cachatj/cistern-water-level-monitor/prompts-plans/display-mockups.md

This mockup looks fantastic. It’s incredibly clean, data-dense without being cluttered, and perfectly optimized for a high-contrast black-and-white e-ink screen. It's an ideal frontend for the wireless water tank level monitor.

To get this rendering beautifully on your Elecrow 5.79" display via PlatformIO, we need to adjust the approach slightly from your previous web-based iterations.

Here is the breakdown of how to translate this design into reality.

### 1. The HTML vs. C++ Reality Check

While HTML/CSS is the absolute best language for a *web dashboard* (e.g., if your ESP32 is hosting a webpage that you view on your phone), it cannot be used to drive the physical e-ink display directly.

Because the Elecrow panel is driven by an SPI interface, the ESP32 needs to send raw pixel data directly to the screen's controller. Therefore, the display code must be written in **C/C++**.

### 2. The Graphics Library Question

Yes, you will absolutely need a graphics library within PlatformIO. You don't want to be calculating individual pixel coordinates from scratch.

For this specific hardware stack, you should target the following:

* **The Display Driver:** **`GxEPD2`** is the gold standard library for e-paper displays in the Arduino/PlatformIO ecosystem. It supports partial refresh (crucial for updating just the "Current: 1,332 gal" text without flashing the whole screen) and handles the complex SPI timing.
* **The Graphics Core:** `Adafruit_GFX`. The `GxEPD2` library inherits from Adafruit's graphics core, which gives you access to simple drawing primitives: `drawRect`, `fillCircle`, `drawLine`, and custom fonts.
* **Fonts:** You will need a custom font library to get those clean, modern typefaces. The `U8g2_for_Adafruit_GFX` library is perfect for this, allowing you to load crisp, anti-aliased fonts onto the ESP32.

*Note: You could look into a heavy UI framework like LVGL, but for a static, non-touch dashboard like this, drawing primitives via Adafruit_GFX is often much lighter on the ESP32's memory and easier to code.*

### 3. How to Prompt the LLMs

When you take this mockup to Gemini Advanced, Claude 3.5 Sonnet, or an IDE assistant, handing them the image alone and saying "code this" will often result in a jumbled mess of misaligned coordinates. AI struggles with exact spatial reasoning from images to C++ canvas coordinates.

To get the best C++ code, you should act as the "layout engine" in your prompt. Give the AI the image, but pair it with a structured prompt like this:

> **System & Hardware:**
> I am building an IoT dashboard using PlatformIO. The hardware is an ESP32 driving an Elecrow 5.79 Inch E-Paper display via SPI. Resolution is 272 (height) x 792 (width), Black/White only.
> **Libraries:**
> Please use `GxEPD2` for the display driver and `Adafruit_GFX` drawing primitives (`drawRect`, `drawLine`, `setCursor`, etc.).
> **Task:**
> Write the C++ layout code for the attached mockup. Do not worry about the sensor logic yet, just create a `drawDashboard()` function with hardcoded dummy variables (e.g., `int currentGallons = 1332;`) so I can test the layout.
> **Layout Constraints (Please follow these coordinate zones):**
> 1. **Left Panel (Width: ~250px):** >    - Draw a large rounded rectangle for the cistern outline.
> * Fill a dynamic rectangle inside it based on a `percentage` variable (currently 73%).
> * Print "73 PERCENT" centered inside the tank.
> 
> 
> 2. **Center Column (Width: ~150px):**
> * Status: Triangle pointing up, text "RISING".
> * Capacity: 1,825 gal
> * Current: 1,332 gal
> * Daily Use: ~45 gal/day
> * Days Remaining: ~29 days (use a larger, bold font for this).
> 
> 
> 3. **Right Panel (Width: ~392px):**
> * Top row: 7 icons representing weather (Mon-Sun). Use simple geometric shapes if actual icons aren't available in the font.
> * Main chart: Draw a line graph showing a 7-day trend. Include a faint grid background (`drawLine` with a dithered pattern or thin lines).
> * Bar chart: Draw two filled rectangles at the bottom of the graph to represent "Rain Measured".
> 
> 
> 4. **Footer:**
> * Left: "Sensor: 42.1cm | Updated 10:42 AM"
> * Right: "Battery Level: 95% | ESP32 CONNECTED"
> 
> 
> 
> 

By breaking the prompt down into "zones" and explicitly naming the libraries (`GxEPD2` and `Adafruit_GFX`), the AI will output highly structured, easy-to-tweak C++ code instead of guessing how to render a web page on an SPI screen.
