cachatj/cistern-water-level-monitor/prompts-plans/System Architecture.png

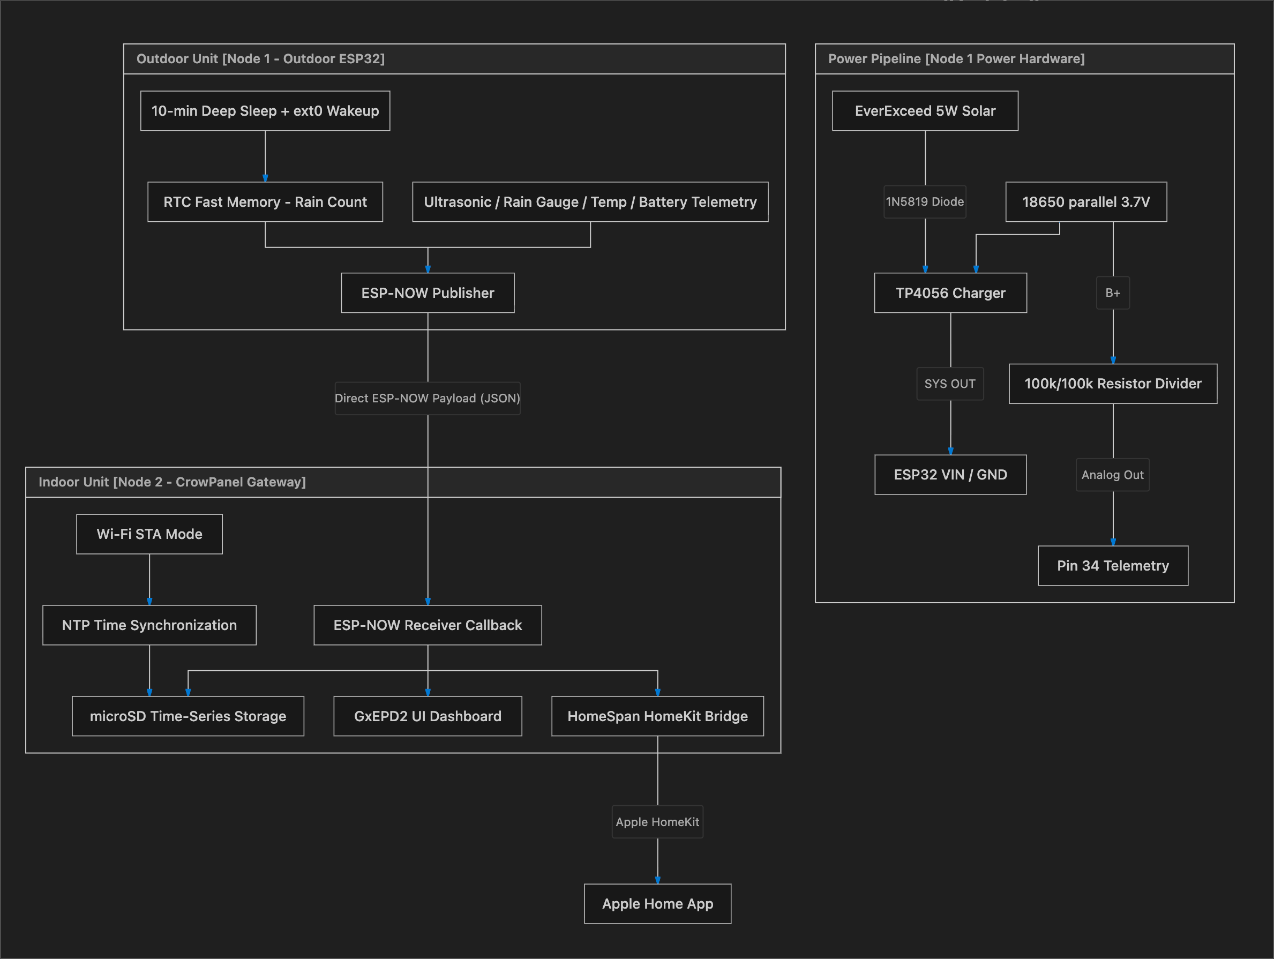
prompts-plans/System Architecture.png
