cachatj/cistern-water-level-monitor/prompts-plans/cister-water-monitor-build-notes.md

CrowPanel MAC Address: 44:1B:F6:95:55:24

smaller speakers look more stable, larger one looks like it could tip easily. also white will get dirty fast

Timestamp, Distance_cm, Gallons, Percentage, Battery_pct, Temp_c, Rain_tips

measured_on, water_surface_dist_cm, estimated_gallons, cistern_percentage, battery_percentage, temp_c, rain_tips
