cachatj/cistern-water-level-monitor/Cistern Node Wiring.html

Cistern Water Level Monitor · Outdoor node · Rev 2

# Outdoor node wiring

Drawn from the updated README (Oct 7, 2026). Pins use the labels printed on the board (D18, VIN). The small text under each one gives the GPIO number used in code and where the pin sits on the board. The sensor wiring is the same in both modes. Only the power source and the top of the battery divider change.

Bench test (USB) Field (solar + battery) Bench test (USB) breadboard

Bench test on your 400-point breadboard. In each numbered row, holes a–e are connected and holes f–j are connected; the center groove separates them. The left strips carry 3V3 (+, red line) and GND (−, blue line). The right strips carry 5V and GND. The ESP32 stays on its terminal adapter beside the board. Wire colors are suggestions, and wires that cross are not connected. The ringed hole in row 26 is the battery-sense test point.

Wire or part | From | To | Purpose
orange wire | ESP32 3V3 terminal | Left + strip, row 29 | Makes the left + strip the 3.3 V rail
black wire | ESP32 GND terminal (right block) | Left − strip, row 28 | Ground
red wire | ESP32 VIN terminal | Right + strip, row 25 | Makes the right + strip the 5 V rail (USB 5 V)
black wire | Left − strip, row 1 | Right − strip, row 1 | Joins the two ground strips
yellow wire | JSN-SR04T Echo | 3j | Echo before the divider (5 V)
R1 · 1 kΩ | 3g | 7g | Divider, top
R2a · 2.2 kΩ | 7h | 11h | Divider, bottom (with R2b)
R2b · 22 kΩ | 7i | 11i | In parallel with R2a = 2.0 kΩ
black wire | 11j | Right − strip, row 11 | Divider to ground
blue wire | 7f | ESP32 D18 terminal | Echo after the divider (≈3.3 V)
red wire | JSN-SR04T 5V | Right + strip, row 2 | Sensor power
black wire | JSN-SR04T GND | Right − strip, row 9 | Sensor ground
green wire | JSN-SR04T Trig | ESP32 D5 terminal | Direct, no breadboard
gauge wire B | Rain gauge switch wire B | 15d | Rain signal
R3 · 10 kΩ | 15b | 19b | Pull-up
orange wire | 19a | Left + strip, row 19 | Pull-up to 3.3 V
purple wire | 15e | ESP32 D27 terminal | Rain signal to the ESP32
gauge wire A | Rain gauge switch wire A | Right − strip, row 16 | Rain gauge ground side
red wire | 22j | Right + strip, row 22 | Top of the battery stand-in
R4 · 100 kΩ | 22h | 26h | Battery divider, top
R5 · 100 kΩ | 26i | 30i | Battery divider, bottom
black wire | 30j | Right − strip, row 29 | Battery divider to ground
teal wire | 26f | ESP32 D34 terminal | Connect last, after row 26 measures 2.4–2.5 V
orange wire | OLED VCC | Left + strip, row 1 | Display power
black wire | OLED GND | Left − strip, row 2 | Display ground
pink wire | OLED SDA | ESP32 D21 terminal | Direct, no breadboard
brown wire | OLED SCL | ESP32 D22 terminal | Direct, no breadboard

Before wiring, check with continuity mode that the top and bottom of each power strip beep (a few boards split the strips in the middle). Push stranded rain-gauge wire ends into a breadboard hole only after twisting and tinning them with solder, or crimp a header pin on.

## Where the terminals are on your adapter

Checked against the photo of your screw-terminal adapter: the labels and their order match. Each terminal block has one extra screw at the top with no label. Leave it empty. Filled terminals are the ones this project uses, and the numbers count the labeled terminals from the top.

The other labels are GPIOs too. VP = GPIO 36 and VN = GPIO 39, both input-only. TX0/RX0 = GPIO 1/3 carry USB serial, so leave them free. TX2/RX2 = GPIO 17/16. EN is the reset line.

## Pin map

On this board, Dn is GPIO n. Firmware uses the number, for example pinMode(18, INPUT).

Board | GPIO | Spot | Connects to | Parts on the line
D5 | 5 | R8 | JSN-SR04T Trig | Direct. 3.3 V reads as HIGH. 20 µs pulse.
D18 | 18 | R7 | JSN-SR04T Echo | 1 kΩ in series, 2.2 kΩ ∥ 22 kΩ (= 2.0 kΩ) to GND
D27 | 27 | L10 | Rain gauge switch | 10 kΩ pull-up to 3V3
D34 | 34 | L4 | Battery divider | 100 kΩ + 100 kΩ. Input-only.
D21 | 21 | R5 | OLED SDA | Bench only
D22 | 22 | R2 | OLED SCL | Bench only
VIN | — | L15 | 5 V rail | Out on USB; in from U3V16F5 in the field
3V3 | — | R15 | 3.3 V rail | Board regulator output
GND | — | L14, R14 | Ground | Either pin

Spot: L = left block, R = right block, counting labeled terminals from the top (antenna end). Skip the unlabeled screw at the top of each block.

## Field junction board (one EPLZON board)

On this board, holes A–E in each numbered column are connected to each other, and so are F–J. Each of those 5-hole strips works as a small rail. A colored strip below is one connection point. Check two holes in the same strip with continuity mode before soldering: they should beep. The ESP32 stays on its screw-terminal adapter, and the TP4056 and U3V16F5 mount on the enclosure plate as modules.

Bars are resistors lying flat, with legs 4 holes apart. R2a and R2b sit side by side in parallel, which makes the 2 kΩ the divider needs. Filled dots are wire holes, and each tag says where that wire goes. Columns not colored stay empty.

### Resistors and jumper

Part | Holes | Bands (1% metal film)
R1 · 1 kΩ | 1A – 5A | brown black black brown brown
R2a · 2.2 kΩ | 5B – 9B | red red black brown brown
R2b · 22 kΩ | 5C – 9C | red red black red brown
R3 · 10 kΩ | 13A – 17A | brown black black red brown
R4 · 100 kΩ | 1J – 5J | brown black black orange brown
R5 · 100 kΩ | 5I – 9I | brown black black orange brown
Jumper wire | 9E – 9F | Joins the two GND strips

### Wires

Strip | Hole | Wire to
5V | 13F | U3V16F5 VOUT
5V | 13G | ESP32 VIN terminal
5V | 13H | JSN-SR04T 5V
3V3 | 17C | ESP32 3V3 terminal
GND | 9J | TP4056 OUT−
GND | 9H | U3V16F5 GND
GND | 9G | ESP32 GND terminal
GND | 9D | JSN-SR04T GND
GND | 9A | Rain gauge wire A
B+ | 1H | TP4056 B+ (second wire on that pad)
Battery | 5G | ESP32 D34 terminal
Echo in | 1C | JSN-SR04T Echo
Echo | 5D | ESP32 D18 terminal
Rain | 13E | Rain gauge wire B
Rain | 13D | ESP32 D27 terminal

Wired directly, not through this board: JSN-SR04T Trig → D5 terminal, TP4056 OUT+ → U3V16F5 VIN, panel → TP4056 IN+/IN−, cell holder → TP4056 B+/B−. Use red wire for 5V, orange for 3V3 and black for GND so the strips are easy to tell apart.

## Check before power-on

1. Set the multimeter to continuity and check each terminal you use (D5, D18, D27, D34, VIN, 3V3, GND) against its pin on the ESP32 itself. Each pair should beep.
2. Echo goes to the 1 kΩ resistor, never straight to D18.
3. Measure the battery-divider junction with a multimeter before wiring D34. Expect ≈2.4–2.5 V. It must be under 3.3 V.
4. Find the rain gauge's switch pair with continuity mode while tipping the bucket. It is normally the center two RJ11 conductors.
5. Aim the ultrasonic probe at a target at least 25 cm away. Closer readings fall in its blind zone.
1. Holder leads read ≤ 4.2 V with both cells in. A reading near 7–8 V means the holder is wired in series.
2. Panel open-circuit voltage in full sun is ≤ 6.0 V. The TP4056 absolute maximum is 6.5 V.
3. U3V16F5 output reads 4.8–5.2 V before the ESP32 is connected.
4. Load grounds go to OUT−, not B−. Otherwise the protection circuit can't disconnect the load.
5. With everything connected, measure deep-sleep current in series with the battery. Expect roughly 15–20 mA.

The 3.3 V rail comes from the ESP32's own 3V3 pin in both modes. Only the 5 V source changes.

## Changed from the rev 1 drawing

- Echo now passes through a 1 kΩ / 2 kΩ divider. The 2 kΩ is a 2.2 kΩ and a 22 kΩ in parallel, both from the kit. Echo no longer connects straight to D18.
- A U3V16F5 boost regulator sits between TP4056 OUT+ and the 5 V rail. The battery no longer feeds VIN directly.
- The 1N5819 diode is gone. The solar cable is soldered straight to TP4056 IN+/IN−.
- System ground is TP4056 OUT−. B− and IN− go only to the cells and the panel.
- The rain gauge (D27 + 10 kΩ pull-up) and the bench OLED are now drawn.
