cachatj/cistern-water-level-monitor/prompts-plans/phased_build_timeline_2026-05-28.png

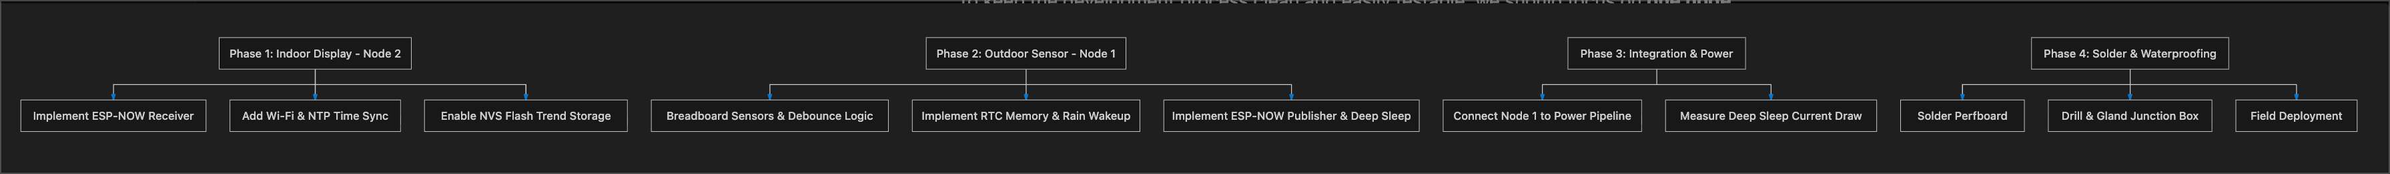
prompts-plans/phased_build_timeline_2026-05-28.png
