cachatj/cistern-water-level-monitor/breadboard-bench-test.png

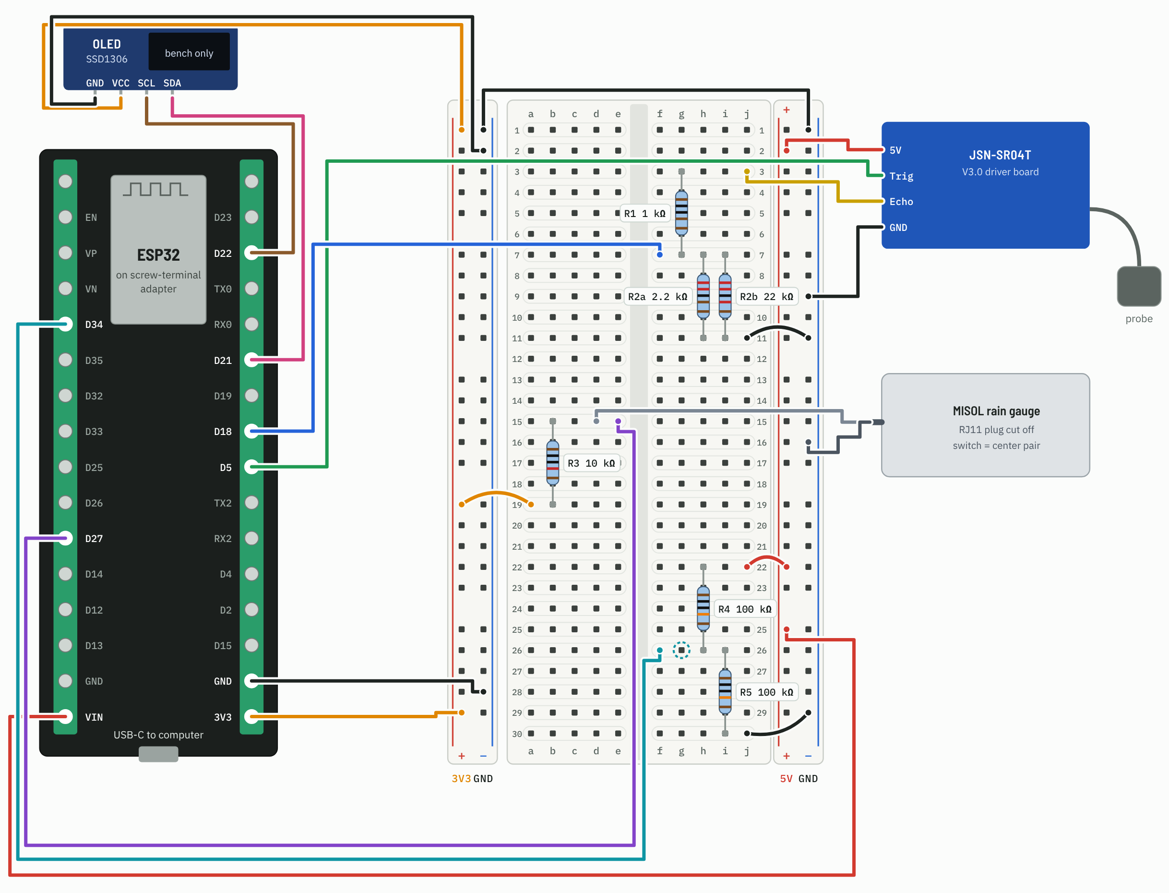
breadboard-bench-test.png
