cachatj/cistern-water-level-monitor/(commit log)

2026-05-28 feat: add ArduinoJson and DallasTemperature dependencies and update main application logic
    [data schema.csv]
2026-10-08 Add WifiEspNow library for ESP-NOW communication
    - Introduced `WifiEspNow` library for ESP8266 and ESP32, providing a simple wrapper for ESP-NOW functions.
    - Added `WifiEspNowBroadcast` class for pseudo broadcast functionality, allowing devices to discover each other via SSID scanning.
    - Implemented examples demonstrating unicast and broadcast messaging using ESP-NOW.
    - Created library properties and README documentation for better usability and understanding.
    - Included a script for code formatting to maintain code quality.
2026-10-08 fix: update hardware manifest and wiring details in README.md for accuracy
